King-Lewy/Speedy-Go-Kart/Images/Example of Welding with Plywood +Nails.png

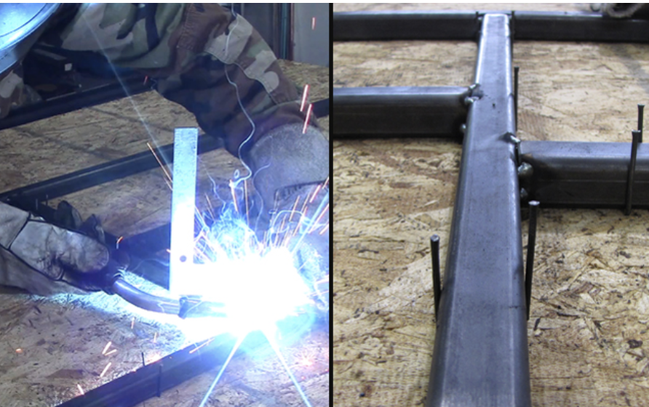
Images/Example of Welding with Plywood +Nails.png
