King-Lewy/Speedy-Go-Kart/Images/Original Sketch.png

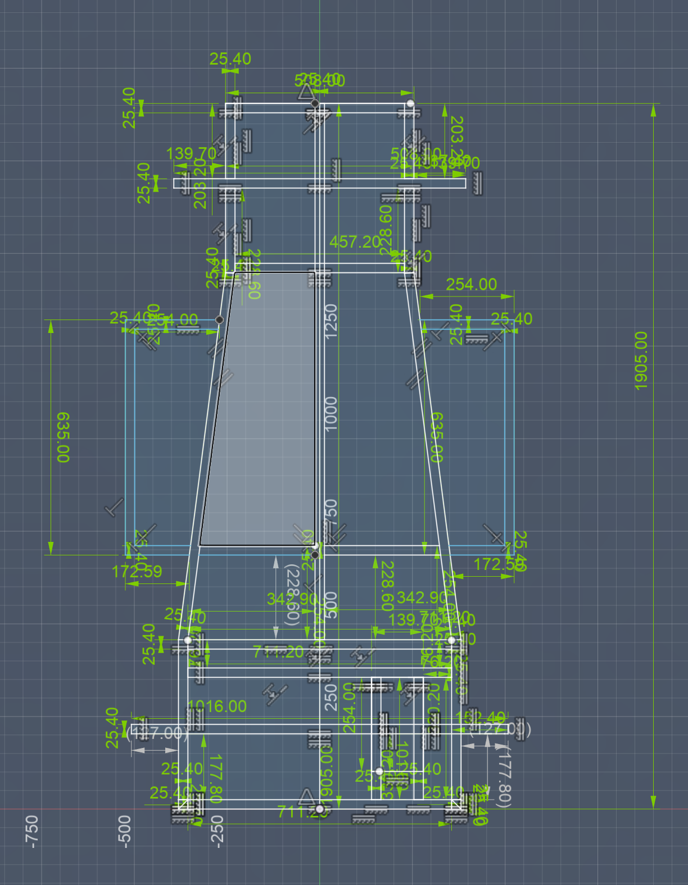
Images/Original Sketch.png
