King-Lewy/Speedy-Go-Kart/Images/Steel Tube Cap 1".png

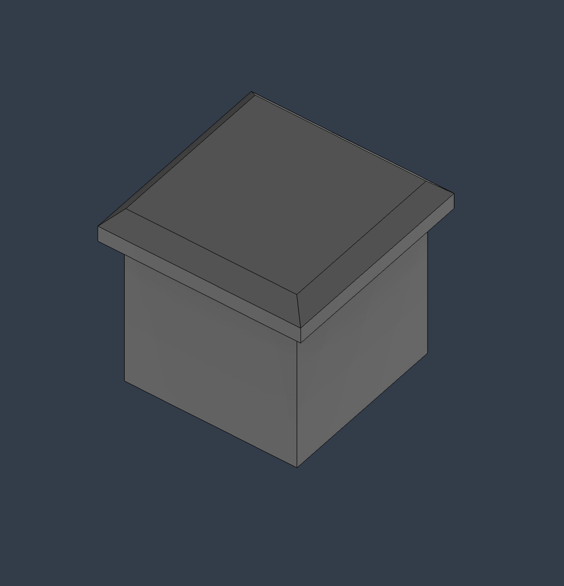
Images/Steel Tube Cap 1".png
