King-Lewy/Speedy-Go-Kart/BOM for Go-Kart - BOM for Go-Kart.csv

Item | Unit Price | Quantity | Total Price | URL
Predator 212cc Engine | $149.99 | 0 (Already Own) | 0 | https://www.harborfreight.com/65-hp-212cc-ohv-horizontal-shaft-gas-engine-epa-69730.html
Back Wheels | $64.95 | 2 | $129.90 | https://www.gopowersports.com/145-x70-6-knobby-wheel-assembly-1-bore
Engine Mounting Plate | $15.99 | 1 | $15.99 | https://www.walmart.com/ip/JRL-Motor-Mount-Plate-Kit-Harbor-Freight-Predator-For-212cc-Engine-Motor-Mount-Plate-Kit-6-5HP-Go-Kart/1553238911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
Front Wheels Set of 2 | $43.88 | 1 | $43.88 | https://www.walmart.com/ip/2-New-WANDA-ATV-Go-Kart-Tires-145-70-6-4PR-P361-10187/125108365?adsRedirect=true
Front Wheel Rims | $29.95 | 2 | $59.90 | https://www.bmikarts.com/6-x-4-12-Floater-Wheel_p_1566.html
Cable Clamp | $6.50 | 1 | $6.50 | https://zero-error.com/products/cable-clamp-2
Brake Cable | $7.95 | 1 | $7.95 | https://www.bmikarts.com/Brake-Cable--65_p_5554.html
Torque Converter | $58.89 | 1 | $58.89 | https://www.amazon.com/GYMMEDS-30-Converter-Predator-Replacement/dp/B0D6Z6VG63?sp_csd=d2lkZ2V0TmFtZT1zcF9hdGY
Rear Live Axle + Brakes + Sprocket Kit | $193.95 | 1 | $193.95 | https://www.bmikarts.com/1-Live-Axle-Kit-35-Chain_p_44794.html
Pedals + Throttle Cable | $16.99 | 1 | $16.99 | https://www.amazon.com/CILOYU-Pedals-Throttle-Accessorise-Predator/dp/B0CVWZQCHG
Plastic Floor Panneling 4'x8' | $47.98 | 1 | $47.98 | https://www.homedepot.com/p/Glasliner-0-090-in-x-4-ft-x-8-ft-White-FRP-Decorative-Wall-Paneling-1-Pack-MFTF12IXA480009600/100389836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
Steering Rod Support Shaft 20" | $12.08 | 1 | $12.08 | https://www.amazon.com/Diameter-1018-Steel-Round-Bar/dp/B0DJ5LLMCB
Steering Shaft Support Bearing | $13.95 | 1 | $13.95 | https://hotrodhardware.com/products/copy-of-borgeson-stainless-steel-rod-end-bearing-steering-shaft-support-1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
Rack and Pinnion Steering | $66.99 | 0 (Already Own) | 0 | https://www.amazon.com/JNDO-Steering-Pinion-Column-Suitable/dp/B0FJ54SFKF?hvadid=812633937494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
1 Inch 14 Guage Steel Tubing 20'+1 Cut | $36.75 | 2 | $73.51 | https://www.wasatchsteel.com/buy-steel/
5/32 in 4'x8' Sanded Plywood for the Seat + welding | $25.32 | 1 | $25.32 | https://www.homedepot.com/p/15-32-in-x-4-ft-x-8-ft-Sheathing-Plywood-Actual-0-438-in-x-48-in-x-96-in-20159/206827282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
Total Price (without tax) : 706.58 + shipping
Total Price (with estimated utah tax) approximatly: 756 + shipping
*Any extra metal from the support rod will be used for emmergencies.
approximatly: 775.11 with shipping no tax
