King-Lewy/Speedy-Go-Kart/CAD/Assembly Designs/Go Kart Assembly With Roll Cage.step

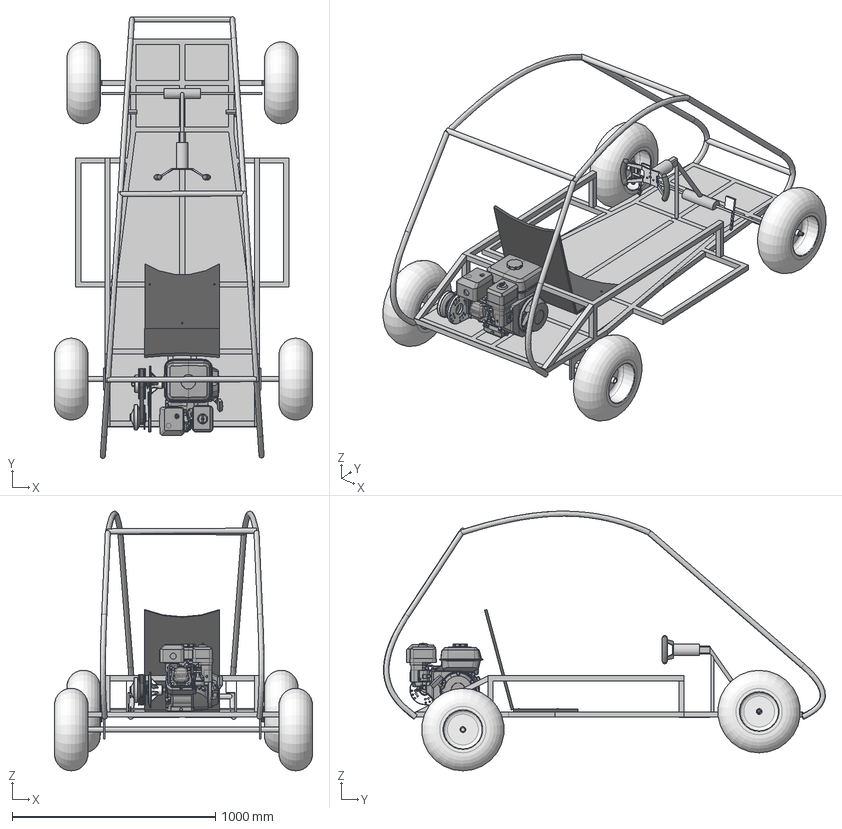
[picture p14: CAD file, 2026-07-14]
CAD/Assembly Designs/Go Kart Assembly With Roll Cage.step
1270.0 x 2174.9 x 1278.0 mm
C:\Temp\GX160
Go Kart Design
base
stage_1_1
european type roller chain wheel_s_din_Chain wheel DIN 8192 - C 10Z 0 8B-1 --10SC26,85H21,5L18N
stage_1_2
stage_1_3
stage_1_4
stage_1_5
stage_2_1
belt
Go Kart Roll Cage
