King-Lewy/Speedy-Go-Kart/CAD/Chassis Designs/Go Kart Chassis.step

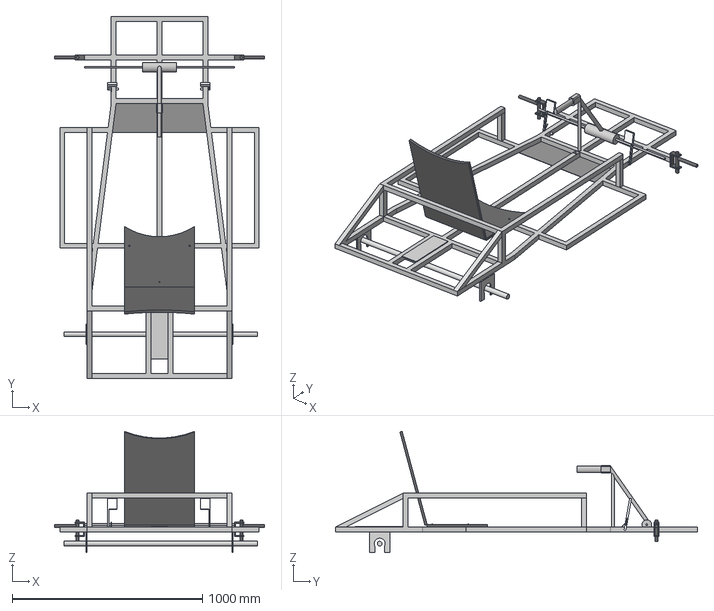
[picture p16: CAD file, 2026-07-14]
CAD/Chassis Designs/Go Kart Chassis.step
1104.9 x 1905.0 x 638.3 mm
