King-Lewy/Speedy-Go-Kart/CAD/Other/14 Gauge Steel Tubing Cap.step

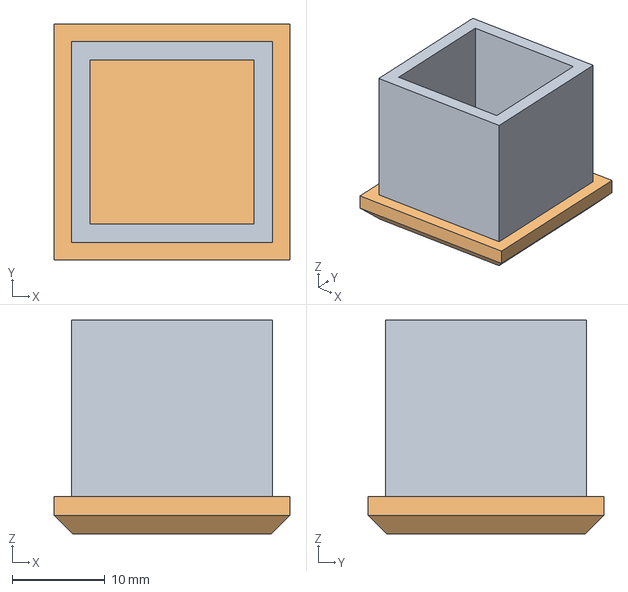
[picture p17: CAD file, 2026-07-14]
CAD/Other/14 Gauge Steel Tubing Cap.step
25.4 x 25.4 x 23.0 mm
