King-Lewy/Speedy-Go-Kart/CAD/Propulsion/Torque Converter.STEP

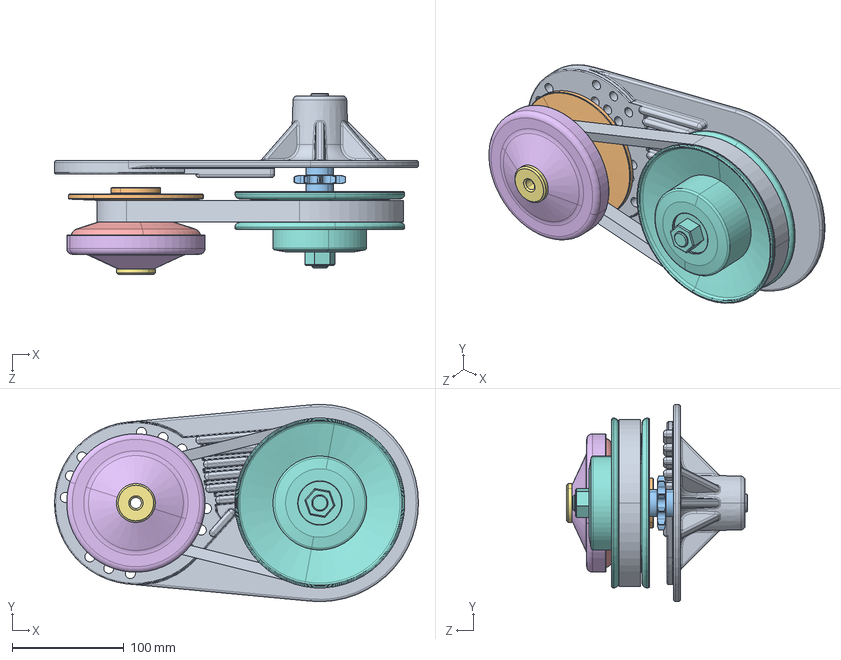
[picture p18: CAD file, 2026-06-26]
CAD/Propulsion/Torque Converter.STEP
326.5 x 176.8 x 162.2 mm
base
stage_1_1
european type roller chain wheel_s_din_Chain wheel DIN 8192 - C 10Z 08B-1 --10SC26,85H21,5L18N
stage_1_2
stage_1_3
stage_1_4
stage_1_5
stage_2_1
belt
