King-Lewy/Speedy-Go-Kart/CAD/Roll Cage/Go Kart Roll Cage.step

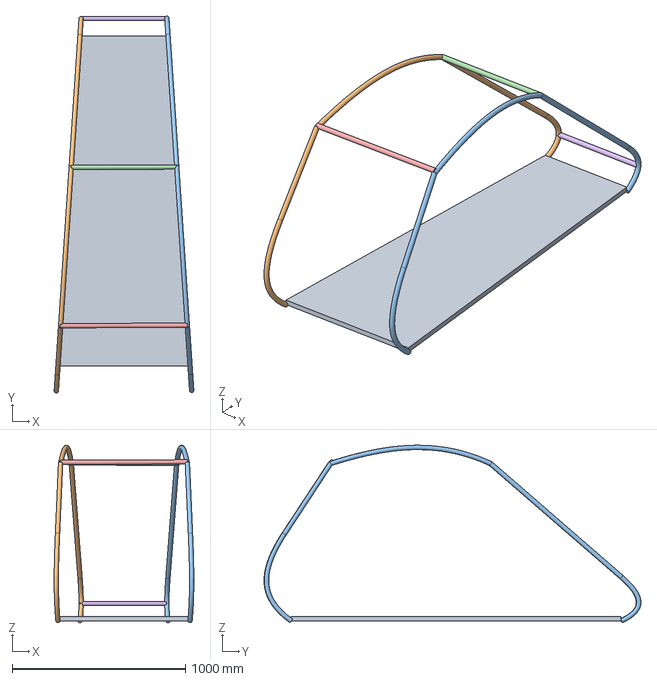
[picture p19: CAD file, 2026-07-14]
CAD/Roll Cage/Go Kart Roll Cage.step
806.3 x 2175.1 x 1024.5 mm
