King-Lewy/Speedy-Go-Kart/CAD/Sprocket Case.step

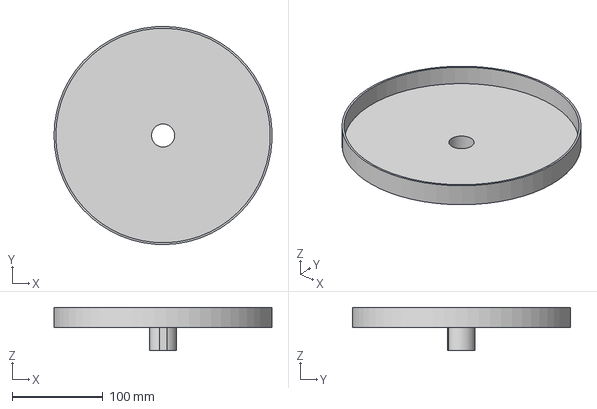
[picture p20: CAD file, 2026-07-19]
CAD/Sprocket Case.step
240.0 x 240.1 x 47.5 mm
