King-Lewy/Speedy-Go-Kart/CAD/Steering Wheel/butterfly-steering-wheel.STEP

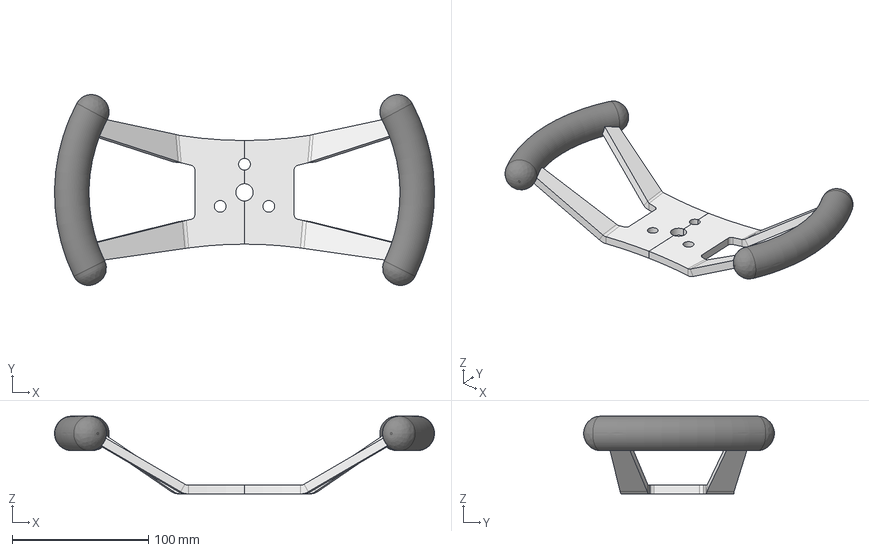
[picture p21: CAD file, 2026-06-26]
CAD/Steering Wheel/butterfly-steering-wheel.STEP
279.4 x 140.3 x 57.1 mm
