King-Lewy/Speedy-Go-Kart/CAD/Wheels/Wheel.step

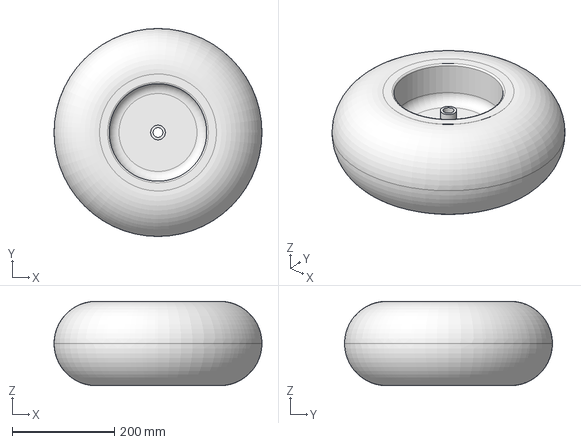
[picture p22: CAD file, 2026-06-26]
CAD/Wheels/Wheel.step
406.4 x 406.4 x 165.1 mm
