King-Lewy/Speedy-Go-Kart/CAD/Go Kart Spoiler.step

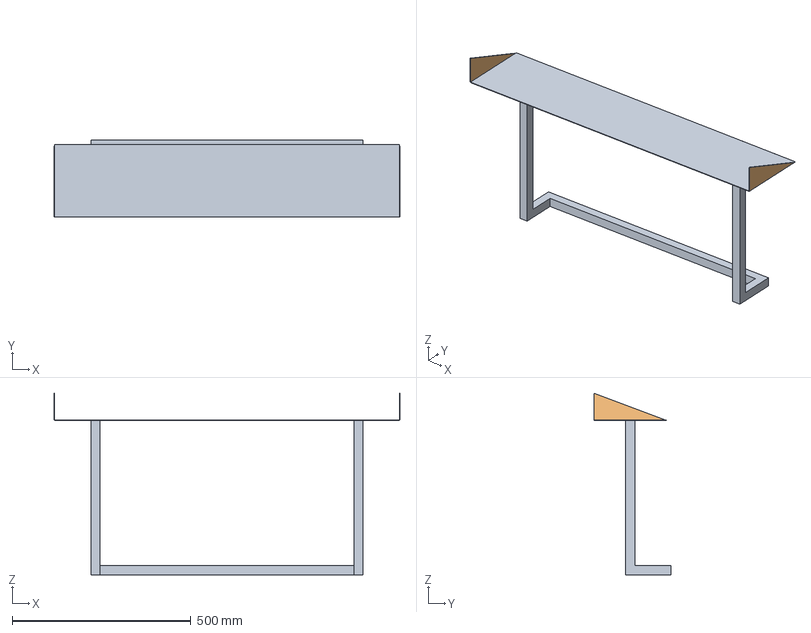
[picture p23: CAD file, 2026-07-19]
CAD/Go Kart Spoiler.step
968.2 x 215.9 x 508.0 mm
