King-Lewy/Speedy-Go-Kart/(list of files, cad)

Other CAD files:
CAD/Assembly Designs/Go Kart Assembly With Roll Cage.f3z
CAD/Assembly Designs/Go Kart Assembly.f3z
CAD/Chassis Designs/Go Kart Chassis.f3d
CAD/Go Kart Spoiler.f3d
CAD/Other/14 Gauge Steel Tubing Cap.stl
CAD/Roll Cage/Go Kart Roll Cage.f3d
CAD/Sprocket Case.f3d
