King-Lewy/Speedy-Go-Kart/Images/Go Kart with roll cage assembly image.png

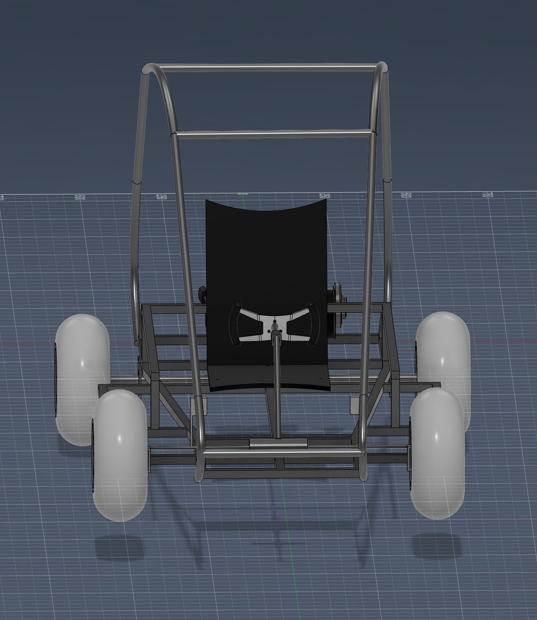
Images/Go Kart with roll cage assembly image.png
