King-Lewy/Speedy-Go-Kart/(commit log)

2026-06-26 Update BOM for Go-Kart.csv
    [BOM for Go-Kart.csv]
2026-06-27 Update BOM for Go-Kart - BOM for Go-Kart.csv
    [BOM for Go-Kart - BOM for Go-Kart.csv]
2026-06-27 Rename BOM for Go-Kart - BOM for Go-Kart.csv to BOM for Go-Kart.csv
    [BOM for Go-Kart.csv]
2026-06-27 Rename Go Kart Assembly After Mentorship.f3z to Go Kart Assembly After Mentorship (Final Design).f3z
    [Go Kart Assembly After Mentorship (Final Design).f3z]
2026-06-27 Rename Go Kart Design After Mentorship.f3d to Go Kart Design After Mentorship (Final Design) .f3d
    [Go Kart Design After Mentorship (Final Design) .f3d]
2026-07-12 Rename Go Kart Assembly After Mentorship.F3d (Final Design).f3z to Go Kart Assembly After Mentorship.f3z (Final Design).f3z
    [Go Kart Assembly After Mentorship.F3z (Final Design).f3z]
2026-07-12 Edit Files
    [Go Kart Assembly After Mentorship.F3z (Final Design).f3z, Go Kart Assembly.f3z.f3z, Go Kart Design After Mentorship.f3z (Final Design) .f3d, Go Kart Design.f3z]
2026-07-14 Rename Go Kart Design.step to Go Kart Chassis.step
    [Go Kart Chassis.step]
2026-07-19 Rename BOM Go-Kart.csv to BOM Go-Kart (no spoiler or roll cage).csv
    [BOM Go-Kart (no spoiler or roll cage).csv]
